FoRTE-Research/REACT-PCB/ReactPcb.kicad_pcb

## KiCad design ReactPcb.kicad_pcb (2024-12-20)

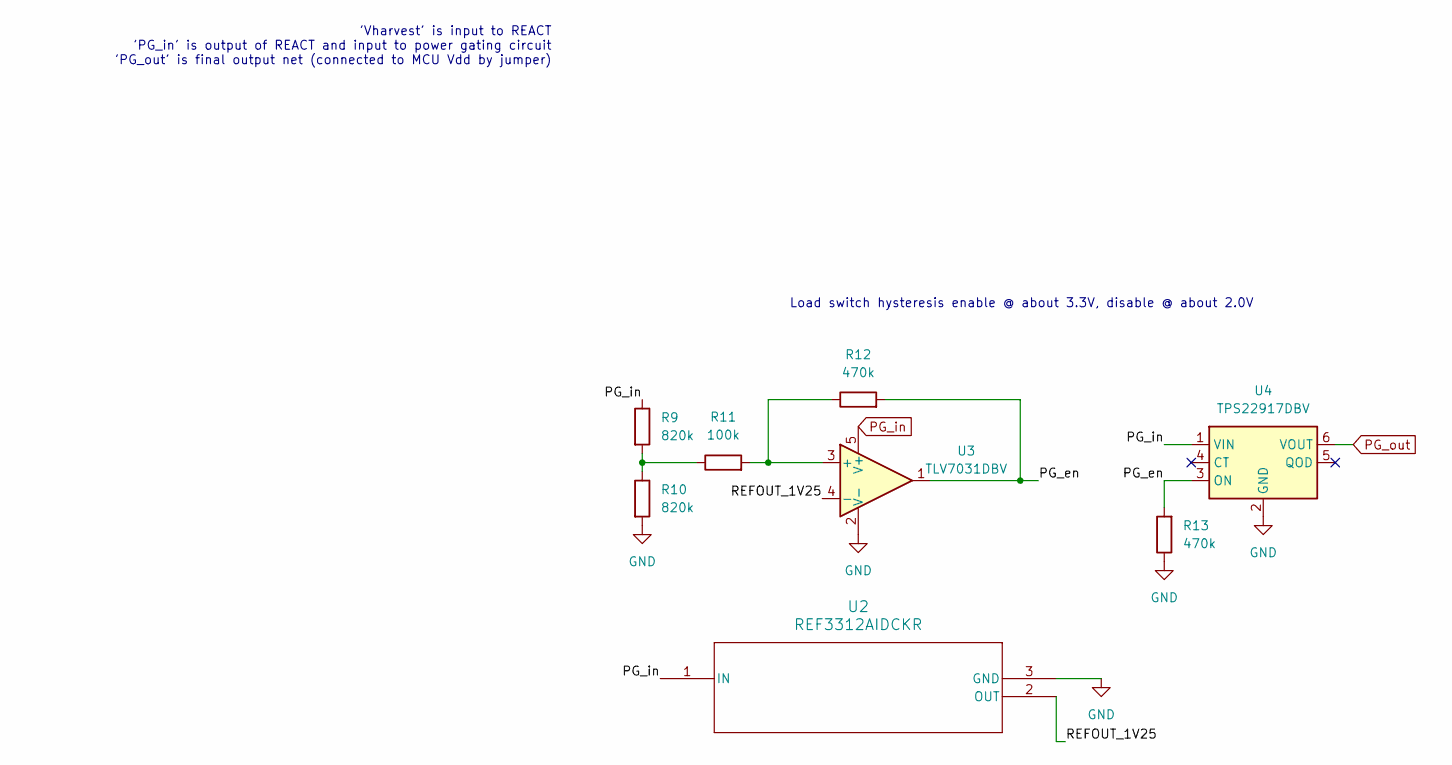
[picture p1: schematic PowerGate.kicad_sch]

Parts:
R9, R10: 820k; R_1206_3216Metric
R11: 100k; R_1206_3216Metric
R12, R13: 470k; R_1206_3216Metric
U2: REF3312AIDCKR; DCK3
U3: TLV7031DBV; SOT-23-5
U4: TPS22917DBV; SOT-23-6

Connections:
/Power Gate/PG_en: R12.2, R13.2, U3.1, U4.3 (ON)
/Power Gate/PG_in: R9.1, U2.1 (IN), U3.5 (V+), U4.1 (VIN)
/Power Gate/PG_out: U4.6 (VOUT)
/Power Gate/REFOUT_1V25: U2.2 (OUT), U3.4 (-)
GND: R10.2, R13.1, U2.3 (GND), U3.2 (V-), U4.2 (GND); also elsewhere on the board
unnamed: R9.2, R10.1, R11.1
unnamed: R11.2, R12.1, U3.3 (+)

Notes on the sheet:
'Vharvest' is input to REACT 'PG_in' is output of REACT and input to power gating circuit 'PG_out' is final output net (connected to MCU Vdd by jumper)
Load switch hysteresis enable @ about 3.3V, disable @ about 2.0V

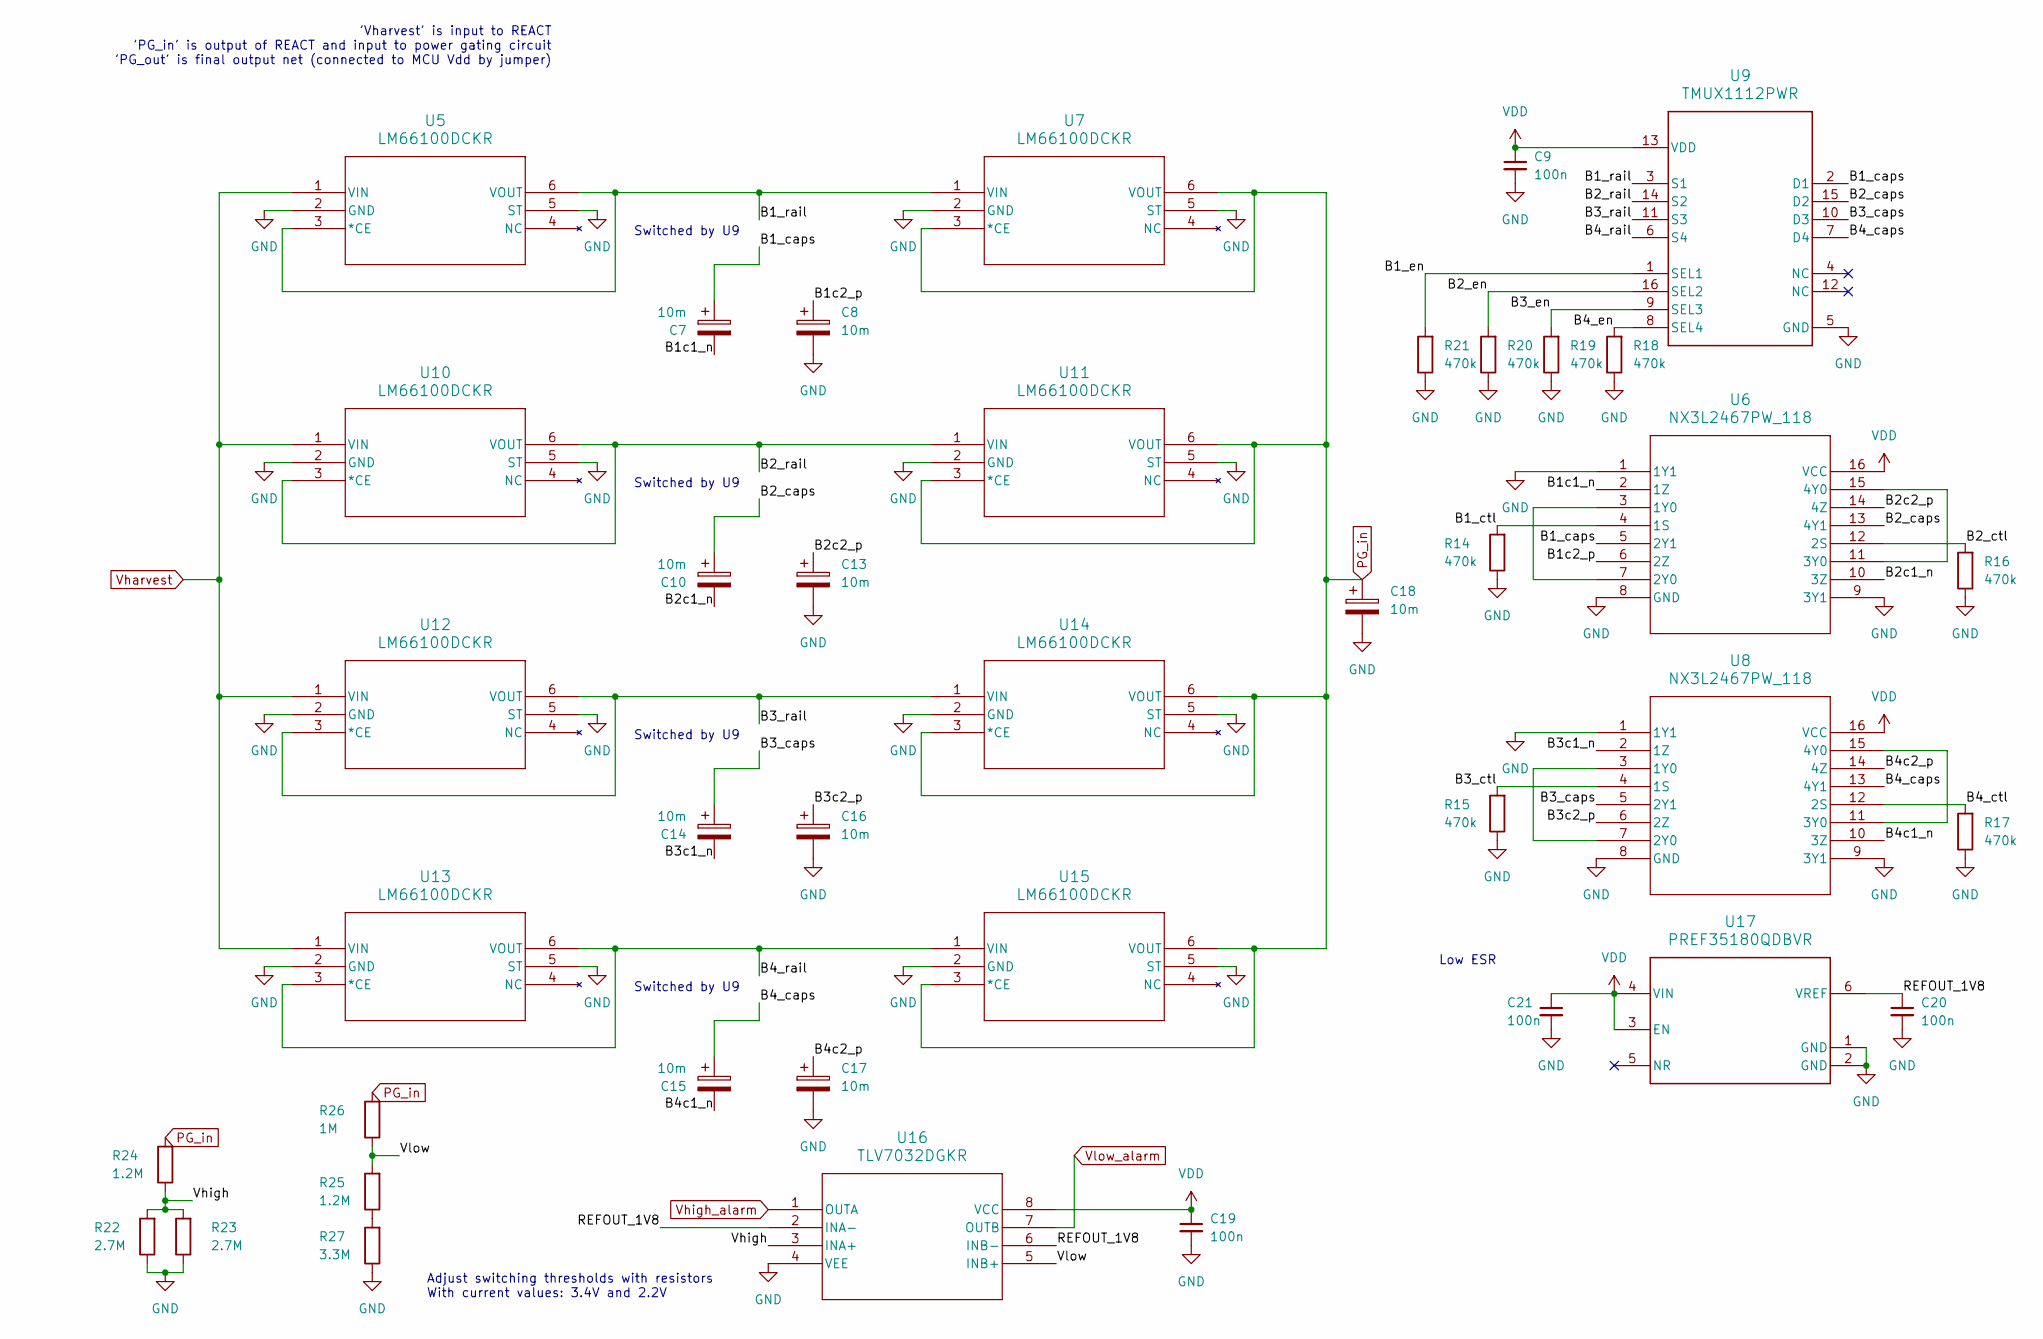
[picture p2: schematic Capacitors.kicad_sch]

Parts:
C7, C8, C10, C13, C14, C15, C16, C17, C18: 10m; C_Rect_L10.0mm_W5.0mm_P5.00mm_P7.50mm
C9, C19, C20, C21: 100n; C_1206_3216Metric
R14, R15, R16, R17, R18, R19, R20, R21: 470k; R_1206_3216Metric
R22, R23: 2.7M; R_1206_3216Metric
R24, R25: 1.2M; R_1206_3216Metric
R26: 1M; R_1206_3216Metric
R27: 3.3M; R_1206_3216Metric
U5, U7, U10, U11, U12, U13, U14, U15: LM66100DCKR; DCK6_TEX
U6, U8: NX3L2467PW_118; TSSOP16_SOT403-1_NXP
U9: TMUX1112PWR; PW0016A-IPC_A
U16: TLV7032DGKR; SOIC_32DGKR_TEX
U17: PREF35180QDBVR; DBV0006A-IPC_A

Connections:
/Capacitors/B1_caps: C7.1, U6.5 (2Y1), U9.2 (D1)
/Capacitors/B1_ctl: R14.2, U6.4 (1S)
/Capacitors/B1_en: R21.2, U9.1 (SEL1)
/Capacitors/B1_rail: U5.3 (*CE), U5.6 (VOUT), U7.1 (VIN), U9.3 (S1)
/Capacitors/B1c1_n: C7.2, U6.2 (1Z)
/Capacitors/B1c2_p: C8.1, U6.6 (2Z)
/Capacitors/B2_caps: C10.1, U6.13 (4Y1), U9.15 (D2)
/Capacitors/B2_ctl: R16.2, U6.12 (2S)
/Capacitors/B2_en: R20.2, U9.16 (SEL2)
/Capacitors/B2_rail: U9.14 (S2), U10.3 (*CE), U10.6 (VOUT), U11.1 (VIN)
/Capacitors/B2c1_n: C10.2, U6.10 (3Z)
/Capacitors/B2c2_p: C13.1, U6.14 (4Z)
/Capacitors/B3_caps: C14.1, U8.5 (2Y1), U9.10 (D3)
/Capacitors/B3_ctl: R15.2, U8.4 (1S)
/Capacitors/B3_en: R19.2, U9.9 (SEL3)
/Capacitors/B3_rail: U9.11 (S3), U12.3 (*CE), U12.6 (VOUT), U14.1 (VIN)
/Capacitors/B3c1_n: C14.2, U8.2 (1Z)
/Capacitors/B3c2_p: C16.1, U8.6 (2Z)
/Capacitors/B4_caps: C15.1, U8.13 (4Y1), U9.7 (D4)
/Capacitors/B4_ctl: R17.2, U8.12 (2S)
/Capacitors/B4_en: R18.2, U9.8 (SEL4)
/Capacitors/B4_rail: U9.6 (S4), U13.3 (*CE), U13.6 (VOUT), U15.1 (VIN)
/Capacitors/B4c1_n: C15.2, U8.10 (3Z)
/Capacitors/B4c2_p: C17.1, U8.14 (4Z)
/Capacitors/Pg_in: C18.1, R24.2, R26.2, U7.3 (*CE), U7.6 (VOUT), U11.3 (*CE), U11.6 (VOUT), U14.3 (*CE), U14.6 (VOUT), U15.3 (*CE), U15.6 (VOUT)
/Capacitors/REFOUT_1V8: C20.1, U16.2 (INA-), U16.6 (INB-), U17.6 (VREF)
/Capacitors/Vhigh: R22.2, R23.2, R24.1, U16.3 (INA+)
/Capacitors/Vhigh_alarm: U16.1 (OUTA)
/Capacitors/Vlow: R25.2, R26.1, U16.5 (INB+)
/Capacitors/Vlow_alarm: U16.7 (OUTB)
GND: C8.2, C9.2, C13.2, C16.2, C17.2, C18.2, C19.2, C20.2, C21.2, R14.1, R15.1, R16.1, R17.1, R18.1, R19.1, R20.1, R21.1, R22.1, R23.1, R27.1, U5.2 (GND), U5.5 (ST), U6.1 (1Y1), U6.8 (GND), U6.9 (3Y1), U7.2 (GND), U7.5 (ST), U8.1 (1Y1), U8.8 (GND), U8.9 (3Y1), U9.5 (GND), U10.2 (GND), U10.5 (ST), U11.2 (GND), U11.5 (ST), U12.2 (GND), U12.5 (ST), U13.2 (GND), U13.5 (ST), U14.2 (GND), U14.5 (ST), U15.2 (GND), U15.5 (ST), U16.4 (VEE), U17.1 (GND), U17.2 (GND); also elsewhere on the board
unnamed: R25.1, R27.2
unnamed: U6.3 (1Y0), U6.7 (2Y0)
unnamed: U6.11 (3Y0), U6.15 (4Y0)
unnamed: U8.3 (1Y0), U8.7 (2Y0)
unnamed: U8.11 (3Y0), U8.15 (4Y0)
VDD: C9.1, C19.1, C21.1, U6.16 (VCC), U8.16 (VCC), U9.13 (VDD), U16.8 (VCC), U17.3 (EN), U17.4 (VIN); also elsewhere on the board
Vharvest: U5.1 (VIN), U10.1 (VIN), U12.1 (VIN), U13.1 (VIN); also elsewhere on the board

Notes on the sheet:
Switched by U9
'Vharvest' is input to REACT 'PG_in' is output of REACT and input to power gating circuit 'PG_out' is final output net (connected to MCU Vdd by jumper)
Low ESR
Adjust switching thresholds with resistors With current values: 3.4V and 2.2V

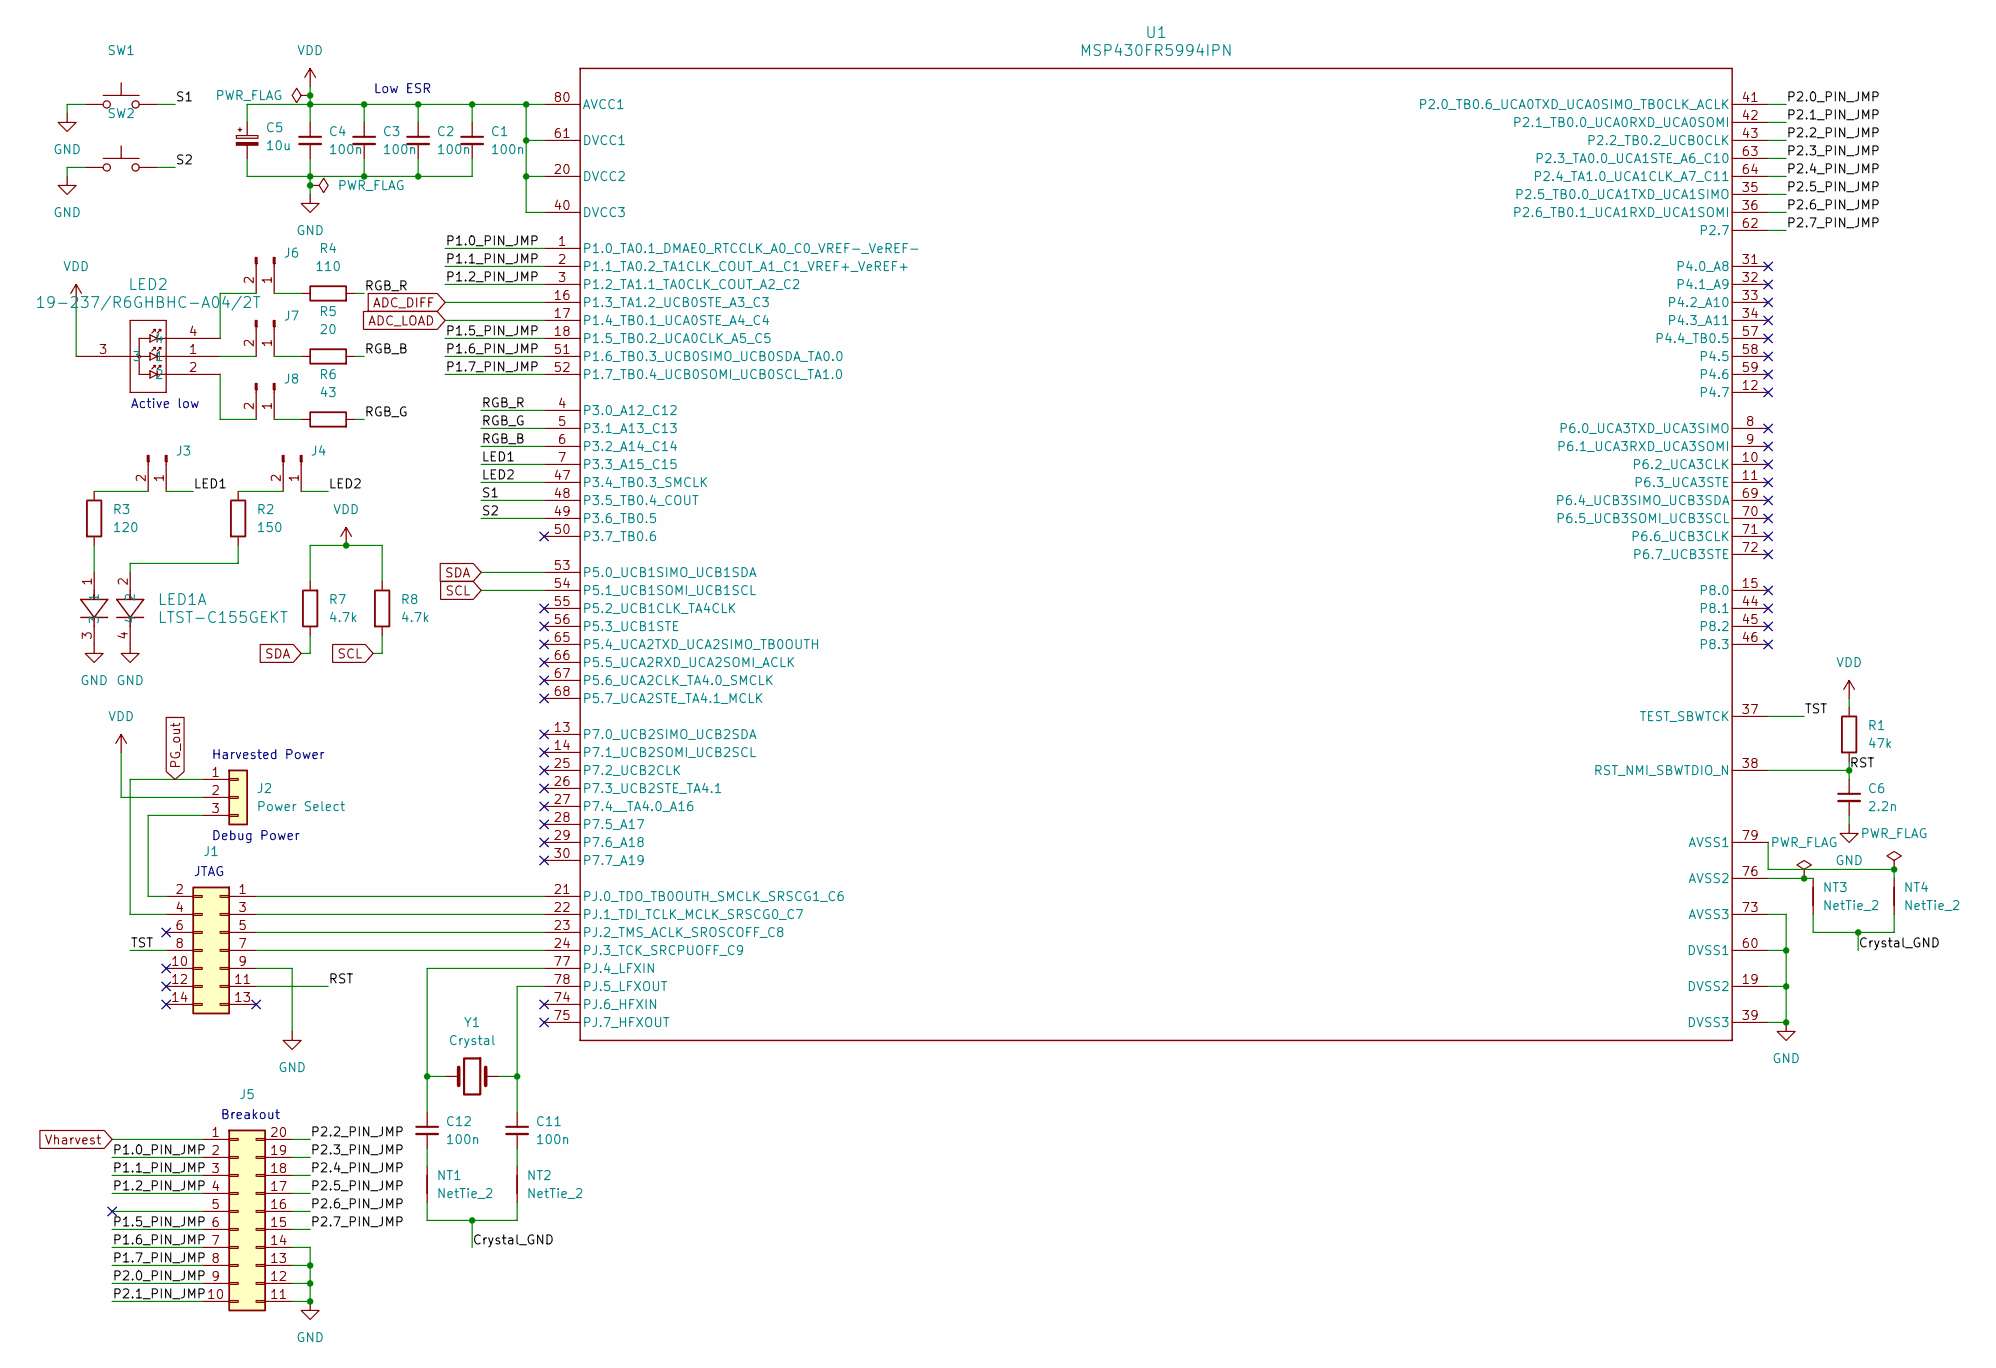
[picture p3: schematic Control.kicad_sch, Control MCU]

Parts:
C1, C2, C3, C4, C11, C12: 100n; C_1206_3216Metric
C5: 10u; C_1206_3216Metric
C6: 2.2n; C_1206_3216Metric
J1: Conn_02x07_Odd_Even; PinHeader_2x07_P2.54mm_Vertical
J2: Power Select; PinHeader_1x03_P2.54mm_Vertical
J3, J4, J6, J7, J8: Conn_01x02_Pin; PinHeader_1x02_P2.54mm_Vertical
J5: Conn_02x10_Counter_Clockwise; PinHeader_2x10_P2.54mm_Vertical
LED1: LTST-C155GEKT; DIODE_LTST-C155GEKT_LTO
LED2: 19-237/R6GHBHC-A04/2T; EAST1616RGB_SMD_B_EVE
NT1, NT2, NT3, NT4: NetTie_2; NetTie-2_SMD_Pad0.2mm
R1: 47k; R_1206_3216Metric
R2: 150; R_1206_3216Metric
R3: 120; R_1206_3216Metric
R4: 110; R_1206_3216Metric
R5: 20; R_1206_3216Metric
R6: 43; R_1206_3216Metric
R7, R8: 4.7k; R_1206_3216Metric
SW1, SW2: SW_Push; SW_TL59NF160Q
U1: MSP430FR5994IPN; PN0080A_N
Y1: Crystal; XTAL_MS1V-T1K-32.768KHZ-12.5PF-20PPM-TA-QC

Connections:
/Control/Crystal_GND: NT1.1, NT2.1, NT3.1, NT4.1
/Control/LED1: J3.1, U1.7 (P3.3_A15_C15)
/Control/LED2: J4.1, U1.47 (P3.4_TB0.3_SMCLK)
/Control/P1.0_PIN_JMP: J5.2, U1.1 (P1.0_TA0.1_DMAE0_RTCCLK_A0_C0_VREF-_VeR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)
/Control/P1.1_PIN_JMP: J5.3, U1.2 (P1.1_TA0.2_TA1CLK_COUT_A1_C1_VREF+_VeRE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)
/Control/P1.2_PIN_JMP: J5.4, U1.3 (P1.2_TA1.1_TA0CLK_COUT_A2_C2)
/Control/P1.5_PIN_JMP: J5.6, U1.18 (P1.5_TB0.2_UCA0CLK_A5_C5)
/Control/P1.6_PIN_JMP: J5.7, U1.51 (P1.6_TB0.3_UCB0SIMO_UCB0SDA_TA0.0)
/Control/P1.7_PIN_JMP: J5.8, U1.52 (P1.7_TB0.4_UCB0SOMI_UCB0SCL_TA1.0)
/Control/P2.0_PIN_JMP: J5.9, U1.41 (P2.0_TB0.6_UCA0TXD_UCA0SIMO_TB0CLK_ACLK)
/Control/P2.1_PIN_JMP: J5.10, U1.42 (P2.1_TB0.0_UCA0RXD_UCA0SOMI)
/Control/P2.2_PIN_JMP: J5.20, U1.43 (P2.2_TB0.2_UCB0CLK)
/Control/P2.3_PIN_JMP: J5.19, U1.63 (P2.3_TA0.0_UCA1STE_A6_C10)
/Control/P2.4_PIN_JMP: J5.18, U1.64 (P2.4_TA1.0_UCA1CLK_A7_C11)
/Control/P2.5_PIN_JMP: J5.17, U1.35 (P2.5_TB0.0_UCA1TXD_UCA1SIMO)
/Control/P2.6_PIN_JMP: J5.16, U1.36 (P2.6_TB0.1_UCA1RXD_UCA1SOMI)
/Control/P2.7_PIN_JMP: J5.15, U1.62 (P2.7)
/Control/PG_out: J1.4, J2.1
/Control/RGB_B: R5.2, U1.6 (P3.2_A14_C14)
/Control/RGB_G: R6.2, U1.5 (P3.1_A13_C13)
/Control/RGB_R: R4.2, U1.4 (P3.0_A12_C12)
/Control/RST: C6.1, J1.11, R1.2, U1.38 (RST_NMI_SBWTDIO_N)
/Control/S1: SW1.2, U1.48 (P3.5_TB0.4_COUT)
/Control/S2: SW2.2, U1.49 (P3.6_TB0.5)
/Control/TST: J1.8, U1.37 (TEST_SBWTCK)
ADC_DIFF: U1.16 (P1.3_TA1.2_UCB0STE_A3_C3)
ADC_LOAD: U1.17 (P1.4_TB0.1_UCA0STE_A4_C4)
GND: C1.2, C2.2, C3.2, C4.2, C5.2, C6.2, J1.9, J5.11, J5.12, J5.13, J5.14, LED1.3, LED1.4, SW1.1, SW2.1, U1.19 (DVSS2), U1.39 (DVSS3), U1.60 (DVSS1), U1.73 (AVSS3); also elsewhere on the board
unnamed: C11.2, NT2.2
unnamed: C12.2, NT1.2
unnamed: J1.1, U1.21 (PJ.0_TDO_TB0OUTH_SMCLK_SRSCG1_C6)
unnamed: J1.2, J2.3
unnamed: J1.3, U1.22 (PJ.1_TDI_TCLK_MCLK_SRSCG0_C7)
unnamed: J1.5, U1.23 (PJ.2_TMS_ACLK_SROSCOFF_C8)
unnamed: J1.7, U1.24 (PJ.3_TCK_SRCPUOFF_C9)
unnamed: J3.2, R3.1
unnamed: J4.2, R2.1
unnamed: J6.1, R4.1
unnamed: J6.2, LED2.4
unnamed: J7.1, R5.1
unnamed: J7.2, LED2.1
unnamed: J8.1, R6.1
unnamed: J8.2, LED2.2
unnamed: LED1.1, R3.2
unnamed: LED1.2, R2.2
unnamed: NT4.2, U1.79 (AVSS1)
unnamed: NT3.2, U1.76 (AVSS2)
unnamed: C12.1, U1.77 (PJ.4_LFXIN), Y1.2
unnamed: C11.1, U1.78 (PJ.5_LFXOUT), Y1.1
SCL: R8.2, U1.54 (P5.1_UCB1SOMI_UCB1SCL)
SDA: R7.1, U1.53 (P5.0_UCB1SIMO_UCB1SDA)
VDD: C1.1, C2.1, C3.1, C4.1, C5.1, J2.2, LED2.3, R1.1, R7.2, R8.1, U1.20 (DVCC2), U1.40 (DVCC3), U1.61 (DVCC1), U1.80 (AVCC1); also elsewhere on the board
Vharvest: J5.1; also elsewhere on the board

Notes on the sheet:
JTAG
Debug Power
Active low
Breakout
Low ESR
Harvested Power

Board: 2 copper layers, 82 parts (0 on the bottom side), 89 nets, no tracks yet.
